ximon/Hot-tub-remote/74LVC1T45.jpg

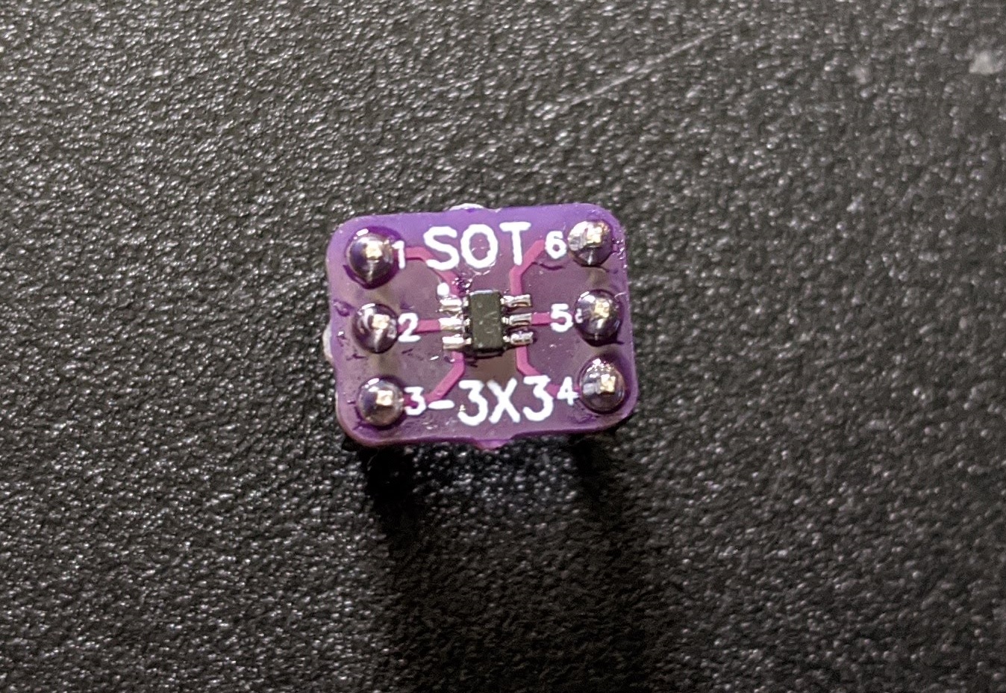
74LVC1T45.jpg
