ximon/Hot-tub-remote/OLS_Traces/interface.png

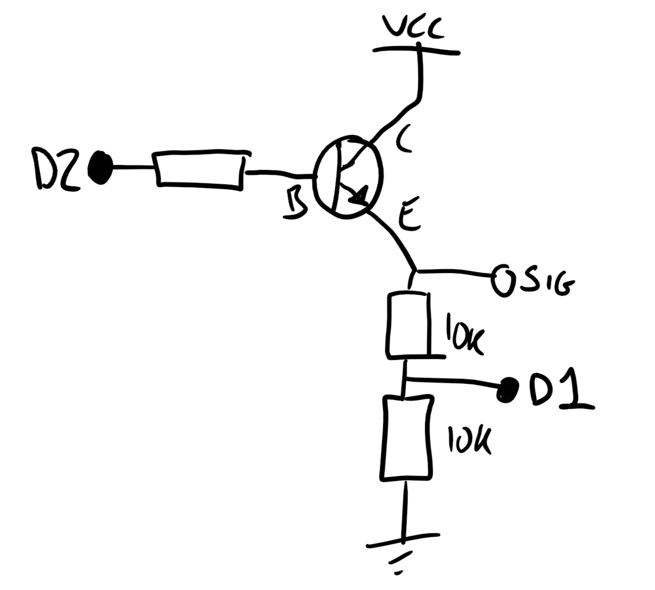
OLS_Traces/interface.png
