ximon/Hot-tub-remote/(threads)

Thread 1 (2019-08-12):

Issue with ESP8266 Arduino IDE board version 2.5.2

dominikkarall, 2019-08-12:
Hi,

can you please add
ICACHE_RAM_ATTR
before the 2 functions which are called by the interrupt handler.
```
ICACHE_RAM_ATTR void handleButtonPress() {
  sendTestCommand = true;
}

ICACHE_RAM_ATTR void handleDataInterrupt() {
  word data = receiveCommand();
  decodeCommand(data);
  lastReceivedCommand = millis();
}
```

Otherwise it crashes on startup, see also
https://github.com/esp8266/Arduino/issues/1734

Many thanks for your great work!

ximon, 2019-08-19:
I've added these, still works with 2.4.2 and now compiles and runs with 2.5.2 also, will double check tonight if moving to 2.5.2 causes any issues.

ximon, 2019-08-20:
Moving to 2.5.2 has uncovered some existing exception issues, I've rewritten the way data is read and written to completely avoid delays in the isr and use timers to check and clock the bits. Will commit after testing (tomorrow hopefully)

ximon, 2019-09-03:
I've re-wrote the data receiving code and it's working well, just looking into abusing i2s to send data with DMA.

ximon, 2019-09-03:
This issue is resolved

Closed 2019-09-03.

Thread 2 (2019-09-08):

ESPHOME compatibility

jperquin, 2019-09-08:
I am running a HASS system on RPi3b with HASSIO and ESPHOME. Mainly because ESPHOME makes managing all components so easy. I have a similar INTEX Spa (with jets and bubbles) and love to be able to use the ground work you have done (kudo's BTW) as a basis for an ESPHOME component.

My programming skills do not go beyond basic yaml, so any suggestions would be appreciated.

ximon, 2019-09-11:
I'd check that it is the three wire model first, as the other models are quite different - there's another project for the four wire model on hackaday.io which might be worht checking out.

I am looking into adding MQTT support once i've ironed out the last few niggles.

jcallaghan, 2020-03-27:
Do you have the link to the four-wire model, please?

ximon, 2020-03-27:
Sure:
[Hackaday project](https://hackaday.io/project/164551-lay-z-spa-remote-control)
[Google docs info](https://docs.google.com/presentation/d/e/2PACX-1vTHQPsuV6sXKc5gxL9crg099udq97GZqN0jf2Jnf2mCJcU21wUM8zd_1vZSeGWA5wYvWniveEIPkd5f/pub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)

ximon, 2020-04-19:
I've started working on MQTT integration on this, will update when i've made progress

jcallaghan, 2020-05-06:
This is really cool to see Simon. Great work! I have analyzed my four-wire Hawaii Hydrojet Pro and am just trying to plan my next stage to integrate using an ESP board.

ximon, 2020-05-06:
MQTT is now part of the project, accepts commands on hottub/cmnd/* and sends out status messages on any status change on hottub/state/status

Swiftnesses, 2020-06-22:
@jcallaghan I have a hydrojet pro, did you get this working on that model?

Closed 2020-05-06.

Thread 4 (2020-04-18):

6 pin version

sanyatuning, 2020-04-18:
Can anyone help me with 6 pin version: [images](https://photos.app.goo.gl/3iwWzNdyU5Ki6gqM6)
Any guess how to start?

Measured on cabels from base unit without the head:
* p1 VCC (based on photo)
* p2 GND (based on photo)
* p3 ? measured: 4.6-4-7V (pulsing, can be digital)
* p4 ? measured: 4.6-4-7V (pulsing, can be digital)
* p5 ? measured: 4.3-4.6V (pulsing, can be digital)
* p6 ? measured: 0V (no guess)

phiberjenz, 2020-04-29:
What is the model number of your pump? I have a #54112 (Swedish market, bought last year). Haven’t opened it up yet but my guess is that it is not 3-pin...

phiberjenz, 2020-04-29:
Nope, I have 4 pins :D

byles, 2020-04-29:
I have 6 pins, when it stops raining I plan to stick the logic analyser on it..

byles, 2020-04-30:
Here's a real quick capture in sigrok pulseview.
I don't really know what I'm doing :)
And it's still wet outside :(
[Archive.zip](https://github.com/ximon/Hot-tub-remote/files/4560407/Archive.zip)

sanyatuning, 2020-05-01:
@byles this is awesome, huge thanks
I have model #54314

byles, 2020-05-01:
I can't make any sense of that short capture if I'm honest... I will do it again properly as soon as the weather is better and at a higher sample rate. Any thoughts on what that connector is? I don't want to hack up mine :)

sanyatuning, 2020-05-02:
mine is [SM connector](https://www.pcboard.ca/image/cache/catalog/products/connectors/jst/jst-sm/4-pin-jst-sm-pair-1-551x551.jpg)

pdecat, 2020-05-03:
FWIW, I've got a model #54129 Palm Springs (French market bought two years ago) and it's a 4 pin.

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

byles, 2020-05-03:
The one I'll be poking around on is #54123 UK market. Thanks to sanyatuning, 6 pin connectors should be arriving in a few days!

byles, 2020-05-03:
Just a thought... I've seen they have an iphone/android app for controlling these things. I wonder if they 5/6th line is for a Wi-Fi adapter of some sort on a newer/higher model.

sanyatuning, 2020-05-05:
@byles what was the state of the hot tub when you captured this?
It was turned on?
It was filtering or heating?
What was the water temperature? (as you remember)

Thanks!

byles, 2020-05-05:
Hey sorry didn't see the email til just now.
I'm attaching a capture from earlier today.

Pin 6 is just the beep, if it's disconnected, there's no beep!

I didn't seem to get any data at all on 3,4 or 5 from the control panel when the control panel was disconnected, maybe it only sends in response to messages from pump during the gap or when polled. master/slave?

3,4 and 5 always have data sending regardless of control panel being connected.

State of machine during this capture:

On
Unlocked
No timer
Bubbles Off
Filter On
Heat On (green - standby/not heating)
35℃ (maybe 36..)

[hottub2.zip](https://github.com/ximon/Hot-tub-remote/files/4583510/hottub2.zip)

sanyatuning, 2020-05-06:
may be correct

this short message is repeating
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

sometimes there is a longer message
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

byles, 2020-05-06:
I wanted to share this before I get into it; I've taken some data with various settings.
Sorry I decoded it as LSB first, we can always change it later.

C0 01 FE 9F FE 0F FE 29 FF F7 FF    37c     heat on     filter on   bubbles off     lock off
C0 01 FE 9F FE 0F FE 21 FF F7 FF    37c     heat on     filter on   bubbles off     lock off
C0 01 FE 9F FE 0F FE 21 FF F7 FF    37c     heat on     filter on   bubbles off     lock off
C0 01 FE 9F FE 0F FE 01 FF F7 FF    37c     heat off    filter on   bubbles off     lock off
C0 01 FE 9F FE 0F FE 01 FF F5 FF    37c     heat off    filter off  bubbles off     lock off
C0 01 FE 9F FE FF FE 21 FF F7 FF    38c     heat on     filter on   bubbles off     lock off
C0 01 FE 9F FE FF FE 41 FF F7 FF    38c     heat stdby  filter on   bubbles off     lock off
C0 0D FE 7F FE 7F FE 21 FF FB FF    100f    heat on     filter on   bubbles off     lock off
C0 01 FE 9F FE FF FE A1 FF F7 FF    38c     heat on     filter on   bubbles on      lock off
C0 01 FE 9F FE FF FE 01 FF E5 FF    38c     heat off    filter off  bubbles off     lock off    -- power off
C0 01 FE 9F FE FF FE 81 FF F7 FF    38c     heat off    filter on   bubbles on      lock off
C0 01 FE 9F FE FF FE 81 FF F5 FF    38c     heat off    filter off  bubbles on      lock off
C0 01 FE 9F FE FF FE 29 FF F7 FF    38c     heat on     filter on   bubbles off     lock on
C0 01 FE 9F FE FF FE 01 FF F5 FF    38c     heat off    filter off  bubbles off     lock off

"01H" / "38" - timer on, alternating display
C0 7F FE 0D FE ED FE 35 FF F7 FF    01H
C0 01 FE 9F FE FF FE 35 FF F7 FF    38c

byles, 2020-05-06:
https://docs.google.com/spreadsheets/d/1mqK0INE1kh0g_M_HerP3LNWXHpvr-ZIPXr-yXfrYt_k/edit?usp=sharing

Sorry, I went LSB first 🙄

sanyatuning, 2020-05-07:
I am using lib [SPISlave](https://github.com/esp8266/Arduino/blob/master/libraries/SPISlave/examples/SPISlave_Test/SPISlave_Test.ino
)
and I got this:
```
[19:51:00][D][HotTub:018]: D8.C1.FE.03.FE.9F.90.FF.AF.FF.11.D8.D8.42.D8.D8.42.D8.D8.42.D8.D8.80.02.03.80.7F.B0.7F.F0.7F.80 (32)
```

byles, 2020-05-07:
So that looks the same as in my spreadsheet, more or less. You have bubbles and heat on?

All mine started C0 so I wonder what C1 is. What state was yours in?

Should I flip the data in my spreadsheet to be msb first? If you want to request edit and add to it feel free.

sanyatuning, 2020-05-07:
fully off or standby
I will capture some data in all states soon

byles, 2020-05-07:
Well, I wouldn't capture any data if it was fully off 😁

Standby, when screen is dim and not running.

sanyatuning, 2020-05-08:
How you capture the data?

byles, 2020-05-08:
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

Cheap logic analyser from Amazon and sigrok. Capturing at 250Hz just so I didn't miss anything. When it was slower sample rate, that clock line wasn't so obviously a clock.

Made jump wires with the SM connectors you identified.

sanyatuning, 2020-05-08:
Can you please share a new capture file?

byles, 2020-05-08:
The hottub2.zip above is the last one Ive done, is what makes up spreadsheet :)

sanyatuning, 2020-05-12:
@byles I wrote a code what reads the current state of the spa.
It is an esphome custom component running on a esp8266.

byles, 2020-05-12:
@sanyatuning nice, would be good to see what you've got. I was busy this weekend so wasn't able to get anything more done yet.

sanyatuning, 2020-05-12:
@byles https://github.com/sanyatuning/hot-tub

chunkysteveo, 2020-05-19:
I have a 4 pin model like @phiberjenz  - would love to get some remote monitoring and management of the 'Tub. Great work so far guys - i'm very interested in this project. Is the 4 pin going to be different to the 6 pin do you think, SPI, I2C?  - V, G, D, C?? has anyone probed the 4-pin version?

reevery, 2020-05-29:
I've also got a four pin version and have ordered some kit to start probing that. Model 54156. Not entirely sure what I'm doing, but will figure it out.

chunkysteveo, 2020-05-29:
Haha good! Keep me posted @reevery ! I suspect the lines are clock and data, and it would just be a case of reversing the protocol and copying. But I've literally no idea!! Would give me an excuse to buy a logic analyser. Was a pain walking to the bottom of the garden today to turn the heater on.... lol #firstworldproblems 😂

chunkysteveo, 2020-06-01:
Found this guys who has a diy product for sale, and uses the 4-pin model too - https://hottubmanager.co.uk/ Only has monitoring states, but surely just need to add in a sending module to the mix to add in the controls? Looks promising too!

reevery, 2020-06-08:
I have finally got round to recording data from the 4-pin.

Pins 1-4 are: vcc, signal 1, signal 2, gnd.
Starts with pump on, heat on, air off. Temp would have been early 30s centigrade. Then heat off, pump off, pump on, heat on, air on, air off, and I think air cycles again.

I really don't know what I'm looking at though.

Data is [here](https://drive.google.com/file/d/1oFCLdTXhxz-6oxqCB74gCrj8YP5WzXa-/view?usp=sharing).

chunkysteveo, 2020-06-08:
Cool! Nice work - hope someone can work with it?!

reevery, 2020-06-14:
I've been trying to make some headway but am struggling a little with direction.

From what I can work out, the 6-pin uses SPI, but I think @ximon yours is UART. Is the 74LVC1T45 then just to split your input and output out? If so, with a signal in and out line on the 4-pin I imagine I don't need this component. What was your baud rate? This is 9600 on mine - does it look similar?
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

If that is the case, then my suspicion is that I can use your code but wiring directly to the ESP.

Would the capacitor be needed in all situations and if so where is it wired in? Is it literally just across VCC and GND of the ESP?

Then the next problem is figuring out how to write the code to the Wemos. I know you posted this link (am copying here for my info mainly): https://averagemaker.com/2018/03/wemos-d1-mini-setup.html

ximon, 2020-06-14:
The hot tub i have uses a three wire cable between the display/buttons and the controller. It uses some odd protocol that i'm not familiar with - dont think it would work with UART due to the really long start pulse in comparison to the rest of the bits - It looks quite a bit different to the images above, yours won't need the 74LVC1T45 - i only needed it due to the DMA hack I'm using to send out the data.

The big capacitor is just a buffer for when the pump and blower motors turn on - It's directly across the supply.

chunkysteveo, 2020-06-24:
Hi @reevery  - I'm going to guess that the protocol is I2C for the 4 pin version. Looks like the 7 step I2C message. If it is, we may need an I2C level shifter board for the ESP to read and write back. Although if those signals are from the two data lines, then there's no clock signal - so could well be asynchronous serial communication, like UART. Hmmm?!!?

reevery, 2020-06-24:
@chunkysteveo There's definitely only two signal wires. pdecat's picture above https://github.com/ximon/Hot-tub-remote/issues/4#issuecomment-623143621 shows Vcc and Gnd on the outer wires. I'm banking on UART but I will investigate it as I2C when I get a chance.

I'm struggling to configure the Wemos at present. It appears their website is kerplunk and I haven't yet found a mirror for it. Baby steps...

eddcaton, 2020-06-25:
Looks like I have the 6 pin version as well 😭 doesn’t anyone have an update on this?

Edd

ximon, 2020-07-01:
If we can make the control code generic enough then we should be able to just #include the relevant control code for each model, I'll take a look at doing this for the current code - 3 pin model.

Can anyone share the model numbers and available dates for the other pumps

This is what i know currently:

Model No.|PinCount|Date|Comments
--|--|--|--
54075|3|~2012|Semi-circle display
54075|10|~2012|Oval display

chunkysteveo, 2020-07-01:
Model No: 54154
PinCount: 4 (Vcc, Data, Data, Gnd)
Model Name: ? From a 'Paris' Tub
Date:  2018?
Country: UK
Comments: Dark-blue/grey, Oval display. Buttons: On/Off Lock, Timer, Bubbles, °C/°F, Heat, Filter, Temp Down, Temp Up

877dev, 2020-07-03:
Hi guys, very excited to see this project, as I just got a new Vegas Lay Z Spa (6 wires). I'm in the UK.

I already have a logic analyser, and have used it to interface with my Accenta alarm panel to create a "virtual" keypad on my phone. (I need to update my github to include that).

Looks like I need some 6pin SM connectors so I can get sniffing!

der-moep, 2020-07-12:
Model No. | PinCount | Protocol | Model Name | Date | Country | Colour | Comments
54123 | 4 | -- | Miami | 2018 | Germany | Grey | Round display
54174 | 6 | -- | Honolulu | 2020 | Germany | Grey | Round display

ximon, 2020-07-14:
> Model No. | PinCount | Protocol | Model Name | Date | Country | Colour | Comments
> 54123 | 4 | -- | Miami | 2018 | Germany | Grey | Round display
> 54174 | 6 | -- | Honolulu | 2020 | Germany | Grey | Round display

Thanks! I've added these to the main list.

877dev, 2020-07-15:
Model No. | PinCount | Protocol | Model Name | Date | Country | Colour | Comments
54112        |    6           |   SPI ?     |     Vegas        | 2020 |     UK     |    Grey  | Round display

ximon, 2020-07-15:
> Model No. | PinCount | Protocol | Model Name | Date | Country | Colour | Comments
> 54112 | 6 | SPI ? | Vegas | 2020 | UK | Grey | Round display

Thanks! I've added this to the main list.

Friseurazubi, 2020-08-03:
Here is the next model ;)

Model | PinCount | Protocol | Name | Date | Country | Colour | Comm
54173 | 4 | ? | Maldives HydrojetPro | 2020 | Germany | Grey | 2 WaterPump

Hawaii HydrojetPro should have the same controller.

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

danjunx, 2020-08-09:
Love this idea! Really interesting in helping out if I can.
I've got 2 Vegas model spas here, one is older than the other by a couple of years, however the internals of the pump "egg" are identical bar some different PCB rev numbers, they have the same model numbers.

I've been doing a bit of googling around and found this project among a few others specifically for the 4 pin version - according to this document, it's using UART, and I can confirm that. [link](https://docs.google.com/presentation/d/e/2PACX-1vTHQPsuV6sXKc5gxL9crg099udq97GZqN0jf2Jnf2mCJcU21wUM8zd_1vZSeGWA5wYvWniveEIPkd5f/pub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)

Following the bit pattern settings on the above document, I was able to hook into the TX/RX sides and sniff the traffic from the control panel/display to the controller unit and see the data being sent between them both. Was not able to sniff the data going the other direction for whatever reason.
I can provide some direct dumps of the serial output from the control panel/display while going through the various functions if required.

Regarding the model number of the pump "eggs" I have and their details:

Model No. | PinCount | Protocol | Model Name | Date | Country | Colour | Comments
54112 | 4 | UART | Vegas | 2015 | UK | Grey | round display, lock/timer/pump/C-F/heater/bubbles/temp up/down, one has a "test" button in place of the power button.

Am curious about the 2 PROG headers on the boards, may be worth trying to dabble with them although I definitely don't have kit to do so at the moment - it looks like there's replacement controller boards for relatively cheap on ebay (at least here in the UK!) and I was tempted to pick one up to dabble with instead of working with my spare pump.

Couple of photos below, note the pinout of the white 4 pin display connector down the bottom left of the board, also the PROG2 header.

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

chunkysteveo, 2020-08-09:
That link is fascinating reading. Need to look into the links to their software etc. Not sure why they have an extra blower button though? Good find though!

faboaic, 2020-08-15:
You all know this one ?
That's what I will try with my lay-z-spa Miami.

https://github.com/visualapproach/WiFi-remote-for-Bestway-Lay-Z-SPA

chunkysteveo, 2020-08-16:
That's a great find too!

ricoghardforth, 2020-10-08:
Is anyone getting anywhere with a four wire version for a esp2866 solution.  Thanks

pejov74, 2020-10-09:
> Is anyone getting anywhere with a four wire version for a esp2866 solution. Thanks

Im also looking for a four wire version for a esp2866 solution.

markgdev, 2020-10-16:
I've been having a look at this based on the link above, I'm hoping to have a basic setup to test in the next few days. Assuming the comms between the display and controller match for my model 🤞

ximon, 2020-10-21:
Not much progress on this lately as my tub's pump shaft has snapped and its dismantled for the time being :(

I'm quite happy to chip in and help with anything though.

TimE90, 2020-12-20:
Did anyone figure out the 4 pin models? Mine is a Lay Z Palm Springs and has four wires. Seems like V, GND and two data’s.
![Uploading D11F6C71-D560-4638-927C-AB089E7056A3.png…]()

markgdev, 2021-01-01:
@TimE90, I’ve finally got a prototype running today. I’ve had to loose the ability to control through the top panel as there is no way to feedback to it that I can find other than the temp. I have kept the blower button active though and this overrides whatever is set remotely.
I will clean up my code and get some details together in the next couple of days and post on here.

TimE90, 2021-01-01:
@markgdev congratulations this sounds pretty good! I‘m looking forward to your updates 👍

markgdev, 2021-01-04:
As promised, I've put some details together here: `https://github.com/markgdev/layzspa_remote` It's still very much a work in progress but the hot tub as been running for the last couple of days now so looks promising.

sanyatuning, 2021-01-04:
@markgdev this looks promising! Thanks for the share!

obalthaz, 2021-01-07:
> As promised, I've put some details together here: https://github.com/markgdev/layzspa_remote It's still very much a work in progress but the hot tub as been running for the last couple of days now so looks promising.

hello, I tested yesterday on my spa, everything works as described.  thank you so much

jenswalit, 2021-04-18:
Hello. I have an 4Pin Lay Z Spa Vegas. I will use your project. Can you say the pin out are the same as yours? Pump No 54112. thank you

sanyatuning, 2021-05-25:
Finally this worked for me: https://github.com/visualapproach/WiFi-remote-for-Bestway-Lay-Z-SPA
but be careful some pins always pulled up/down and cant be used with level shifters

Closed 2021-05-25.

Thread 6 (2020-05-06):

Question : More Informations on electronic part

RonandoDeLaVega, 2020-05-06:
Hello,

First of all, well done for your work, this looks amazing !!

I'm a bit new in eletronic and I can't figure out how you made your schema ? Do you have photos of actual PCB ?

Where the condensator should be linked to ?
What is the component in the middle with VCCA VCCB A B and DIR in entries ?

Thanks !
Ronando

eddcaton, 2020-05-08:
Yes @RonandoDeLaVega  would be good to have a more in depth electrical connection guide.

ximon, 2020-05-10:
Hi,

The esp8266 talks to the hot tub via the three pin cable between the display and the main controller.
This is done through a level shifter, a 74LVC1T45, this is the component with the VCCA,VCCB, A, B and DIR pins.

The level shifter is used as the hot tub signals are 5v and the esp8266 is 3v3, its also used to turn the output on and off before and after sending commands as its using a DMA hack which doesnt quite produce the required signals.

The condensator (capacitor) is connected across the supply just to smooth out the dips when the esp8266 is transmitting.

I've updated the schematic to clear up the net names and swap the diode with a switch to aid in local programming.

I cant upload a photo of the device as it's inside my hot tub, next time i have it open i'll take a photo.

Hope this helps!
Simon.

jampez77, 2020-05-19:
So I've just bought some 74LVC1T45's and I was wondering 1, how on earth you connected them the anything and 2, do you know where I can get a non-mircoscopic version of them?

Simon-Keen, 2020-05-19:
I soldered one onto [this breakout board](https://oshpark.com/shared_projects/8Vwts4jC)

You can use any non-inverting bidirectional three state driver with direction input.

ximon, 2020-05-19:
I soldered one onto [this breakout board](https://oshpark.com/shared_projects/8Vwts4jC)

You can use any non-inverting bidirectional three state driver with direction input.

RonandoDeLaVega, 2020-05-19:
Hello,
I found [this ](https://fr.aliexpress.com/item/32866573215.html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,searchweb201602_,searchweb201603_)which looks to be useful

jampez77, 2020-05-19:
> Hello,
> I found [this ](https://fr.aliexpress.com/item/32866573215.html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,searchweb201602_,searchweb201603_)which looks to be useful

From what I've seen, both online and in person, the 74LVC1T45's are tiny. Smaller than the sockets in that url.

Simon-Keen, 2020-05-19:
This is the [74LVC1T45GW SOT-363](https://uk.rs-online.com/web/p/buffer-converter-combinations/8168791/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) mounted to [this breakout](https://oshpark.com/shared_projects/8Vwts4jC)

If anybody needs one i now have two spare breakoutboards with 74LVC1T45s mounted.

It's pretty easy to solder, just tin one pad, place the part, reflow the pad, then solder the others.
Thin solder, flux and a good iron make it really easy.

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

ximon, 2020-05-19:
This is the [74LVC1T45GW SOT-363](https://uk.rs-online.com/web/p/buffer-converter-combinations/8168791/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) mounted to [this breakout](https://oshpark.com/shared_projects/8Vwts4jC)

If anybody needs one i now have two spare breakoutboards with 74LVC1T45s mounted.

It's pretty easy to solder, just tin one pad, place the part, reflow the pad, then solder the others.
Thin solder, flux and a good iron make it really easy.

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

RonandoDeLaVega, 2020-05-19:
Hello,

Here is my shop list, does it seems right to you ?
I've got a doubt on the capacitor : is 16V OK ?

- [switch](https://www.aliexpress.com/item/32832214619.html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,searchweb201602_,searchweb201603_)
- [capacitor](https://www.aliexpress.com/item/32954075821.html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,searchweb201602_,searchweb201603_)
- [Wemos D1 Mini](https://www.aliexpress.com/item/32651747570.html?spm=a2g0s.9042311.0.0.54e04c4dNBfryS)
- [74LVC1T45 ](https://www.aliexpress.com/item/33020199381.html?spm=a2g0s.9042311.0.0.54e04c4dNBfryS)
- [SOT23 adaptator](https://www.aliexpress.com/item/33020199381.html?spm=a2g0s.9042311.0.0.54e04c4dNBfryS)

After I'll receive all this stuff, I'll have to figure out how to flash the ESP8266 ... any keyword to search on google ? :-D

Thanks a lot !
Ronando

jampez77, 2020-05-19:
>
> After I'll receive all this stuff, I'll have to figure out how to flash the ESP8266 ... any keyword to search on google ? :-D
>

Try this:  https://averagemaker.com/2018/03/wemos-d1-mini-setup.html

ximon, 2020-05-21:
@RonandoDeLaVega  Your list seems fine apart from the sot adapter, the link is for the 74lvc1t45.
The switch is optional, you can just use a jumper if you have one spare.

You might want to check out the platformio branch too, i'm moving away from the arduino ide so all new updates will be in that branch and will eventually be merged into master.

eddcaton, 2020-06-19:
Hey,

Can anyone tell me if this is the right part?
https://www.ebay.co.uk/itm/193386434279

Edd

ximon, 2020-06-19:
Hi Edd, yeah, that'll do the job

eddcaton, 2020-06-19:
Thanks :)

dominikkarall, 2020-06-21:
Hi,
I got my 74LVC1T45 today, but unfortunately I haven't found a capacitor in my spare components. Do I really need it and is it necessary to be exactly the 1000uF one you have in your semantics? I just wired it together without capacitor. Receiving signals works perfect, but sending doesn't work at all (branch: platformio-fixes).

ximon, 2020-06-21:
The size of the capacitor isn't super critical, its just a local buffer for when the pumps turn on, you might get away without it - I added it at the time when I was seeing a lot of exceptions occurring, seemed to make a difference - but it could also have been code changes.

It might be worth hooking a scope up to the supply to the esp and watching what happens when the heater / pump turns on / off.

With regards to the platformio-fixes branch - I mistakenly checked some work in that wasn't fully tested and had to spend some time unpicking the parts that worked. I've rewrote the receiveing code which seems a lot more accurate in decoding the messages ( I tried this method before but kept seeing exceptions )

I'll check in the latest changes once i've got it tested.

dominikkarall, 2020-06-24:
I just tested it with a 1000uF capacitor, unfortunately it still doesn't work. Can you please let me know if you use the 5V from the 3-wires to run the ESP8266? Receiving works perfectly, but sending doesn't work at all. It seems to send some signals as I can see all lights flashing very short on the hot tub display.

ximon, 2020-06-24:
Yes - mine is soleley powered from the tub using the three wires going to the display controller.

Try with the main branch, i've merged the new platormio code in which runs a lot better for me.

Do you have a logic analyser you can check things out with if it still doesn't work?

Thread 7 (2020-05-11):

Changing temperature from the esp doesn't result in the correct temperature

ximon, 2020-05-11:
When changing the temperature from the esp it seems to under / overshoot the temperature it's aiming for

ximon, 2020-05-11:
It's just occurred to me that this will be caused by the temperature reading for the target temperature only being taken once and won't be read again until the display stops flashing, then starts flashing again.

The target temperature readings need to be taken until the display stops flashing or temp up / down commands are no longer being sent.

ximon, 2020-05-26:
Resolved in platformio branch

Closed 2020-05-26.

Thread 8 (2020-06-01):

Error state detection broken

ximon, 2020-06-01:
Detection of error states seems to be broken, pump was showing E02 but the status JSON wasn't showing the error.

ximon, 2020-06-23:
Fixed in platformio-fixes branch

Closed 2020-06-23.

Thread 9 (2020-06-04):

Installation Instructions

jampez77, 2020-06-04:
I'm really keen to try this idea on my hot tub. Would it be possible to have some info on how you installed it on yours?

Even if it's just some photos of your setup.

Thanks

Simon-Keen, 2020-06-05:
I didn't take pictures when i was connecting it up but its just a case of tapping into the three wires that connect the main controller to the display.

There will be vcc, data and ground wires - I used a multimeter to determine which was which.

Just connect the vccr, data and ground to the relevant pins on the schematic (labelled hot tub)
(think i missed it from the schematic but the vcc will also need to go to the d1 mini's 5v in)

Thread 10 (2020-06-22):

HTML Interface

eddcaton, 2020-06-22:
Hey All,

I have this system working now and it's great!

Just one question. In the download, there is a folder TestPage with an HTML index file in it. Has anyone been able to get this installed and working? If so how? As I don't really need to use the REST API with the way I have set things up. I would just like a webpage I can logon to.

Edd

ximon, 2020-06-23:
I have a really basic page that I use for testing, its has no styling and is completely unfinished - I am planning on making it a bit nicer but I've been concentrating on making the receiving code rock solid.

Feel free to create one that talks to the API and submit a PR 👍

eddcaton, 2020-06-23:
Hey @ximon,

Would you mind posting the version you have and I will take a look at styling etc.

Edd

ximon, 2020-06-24:
You should be able to run the test page from a webserver / githack.

[Try this](http://raw.githack.com/ximon/Hot-tub-remote/87d7ac6020e7dc4f0b9f96ada929dea6b3f97524/TestPage/index.html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) - Just swap the ip in the querystring with whatever your esp local ip is

chunkysteveo, 2020-07-01:
I'd be happy to style up the interface page with a nice and simple Bootstrap layout. If the 4-pin version is ever cracked!! lol

ximon, 2020-07-01:
I started writing an interface in angular using material design, check out the HotTubRemoteUI branch

chunkysteveo, 2020-07-01:
Ah coo, i'll leave you to it then. 👍

ximon, 2020-07-01:
I'm not a designer mind, so if you fancy putting something together with angular material go for it 👍

chunkysteveo, 2020-07-01:
Never used Angular material to build, i'm a PHP dev and work with classic HTML, CSS, JS. I'd have to start from scratch 😒 😄

eddcaton, 2020-07-01:
I have started a php layout using curl requests which is shaping up quite nicely. Just need to workout how to get the pump and bubble status so I can display its value on the dashboard. Also I can’t currently test fully as I have the 6 pin version  :(

Thread 14 (2020-06-30):

Stability Issues

ximon, 2020-06-30:
Everything seems to be really unstable with multiple restarts happening often, also pin change interrupts seem to miss some transitions and mess with the message receiving.
This seems to have increased since moving to timer and interrupt driven message decoding.

Current options for this, in order of preference:

1. Look into removing the timers and doing message encoding / decoding in loop()
2. Have a separate IC do the message encoding / decoding and talk to the esp8266 over serial
3. Use an esp32 and dedicate one core or the ULP to the message encoding / decoding.

Anyone have any thoughts / suggestions / tips?

dmeagor, 2020-07-01:
I'm certainly no expert but I would think that option 3 is the cleanest solution as one $5 dev board can then handle everything.  Option 1 and 2 looks like unnecesseswary development with Option 1 looking like a a bodge.  Seems like the 8266 is being phased out anyway.  Tiny bonus, you could potentially use the esp32 internal temperature sensor to monitor outside temp (after calibrating with an offset.)

ximon, 2020-07-01:
Esp32 was my last choice purely because I was determined to get this running perfectly on the esp8266 but it's been plagued with problems since I started the project - I think it's down to the frequency of the interrupts.

I have a couple of esp32 dev boards spare I'll do some testing with and see how things go. Hopefully it'll be as simple as having WiFi one one core and everything else on the other, I haven't looked deeply into the ulp but it from what I have heard it sounds like an ideas choice for decoding.

ximon, 2020-07-01:
Pretty sure the IRRemote library does its receiving/decoding from a function called in loop, works perfectly at the low message rates I have used it for - could be a simple solution with not a lot of effort.

chunkysteveo, 2020-07-02:
ESP8266 seem to struggle with high demand things theses days. I remember when the ESP32 was a luxury board to use - seems like it's becoming the go-to board now unless you have something simple with limited pins etc.

ximon, 2020-07-02:
I'll branch the current esp8266 code and make another branch for the esp32, once confirmed it's working i'll merge the esp32 code into main and leave the esp8266 for reference.

Thread 15 (2020-11-21):

Water pump rattles

visualapproach, 2020-11-21:
Not much progress on this lately as my tub's pump shaft has snapped and its dismantled for the time being :(

I'm quite happy to chip in and help with anything though.

_Originally posted by @ximon in https://github.com/ximon/Hot-tub-remote/issues/4#issuecomment-713896636_
