ximon/Hot-tub-remote/Interface/Interface.sch

## KiCad design Interface/Interface.sch (2020-06-24, an earlier design)

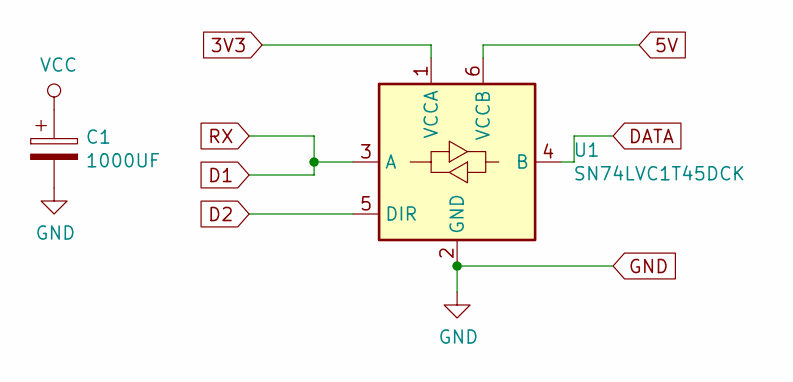
[picture p7: schematic Interface.sch]

Parts:
C1: 1000UF
U1: SN74LVC1T45DCK; SOT-363_SC-70-6

Connections:
3V3: U1.1 (VCCA)
5V: U1.6 (VCCB)
D1: U1.3 (A)
D2: U1.5 (DIR)
DATA: U1.4 (B)
GND: C1.2, U1.2 (GND)
VCC: C1.1
