ximon/Hot-tub-remote/src/HotTub.h

#ifndef HOTTUB_H
#define HOTTUB_H

#include <ArduinoJson.h>
#include "Commands.h"
#include "Temperatures.h"
#include "SendReceive.h"
#include "State.h"

#include <Syslog.h>

#define INIT_TEMP 37 //Temperature to initially set to when powering up.

#define WAIT_BETWEEN_SENDING_AUTO_COMMANDS 500
#define WAIT_BEFORE_INITIAL_TARGET_TEMP_CHECK 5000 //milliseconds after startup to wait before checking the initial target temperature

#define DELAY_BETWEEN_PRINTS 1000

#define TEMP_BUTTON_DELAY 2000         //time to wait after a button is pressed to run the target temperature check
#define TEMP_TARGET_INITIAL_DELAY 6000 //Time to wait before sending a button command to get the target temperature
#define TEMP_CURRENT_DELAY 6000        //Time to wait before taking the reading as the current temperature
#define TEMP_TARGET_DELAY 250          //Time to wait before taking the reading as the target temperature

#define TEMP_ADJUST_DELAY 3000 //must be less than TEMP_IGNORE_TIME!!
#define BUTTON_SEND_DELAY 1000 //time to wait before sending buttons to change state

class HotTub : public SendReceive
{
public:
  HotTub(int dataInPin, int dataOutPin, int debugPin, Syslog *syslog);

  CurrentState *getCurrentState();
  TargetState *getTargetState();
  void setTargetState(int newState);
  int setTargetTemperature(int temp); //todo - setting in EEPROM

  int setLimitTemperature(int temp); //todo - setting in EEPROM
  int getLimitTemperature();

  int targetTemperatureValid(int targetTemp); //todo - make private and do all temperature validation in this class
  int maxTemperatureValid(int maxTemp);       //todo - make private and do all temperature validation in this class
  int tempValid(int temperature, int minTemp, int maxTemp);

  void setTemperatureLock(bool enable); //todo - setting in EEPROM
  void setAutoRestart(bool enable);     //todo - setting in EEPROM

  char *getStateJson();

  void onCommandSent(unsigned int command);
  void onCommandReceived(unsigned int command);

  void loop();
  void setup(void (&onStateChange)(const char *reason), void (&onSetTimer)(uint32_t ticks));

private:
  void (*stateChanged)(const char *reason);

  Syslog *logger;

  CurrentState *currentState;
  TargetState *targetState;

  unsigned long tempIgnoreStart = 0; //start time to ignore temperature commands from

  bool manuallyTurnedOff;          //indicates to the autoRestart code that the pump was turned off via the button / command, rather than the 24h timeout
  int limitTemperature = MAX_TEMP; //limits the temperature that can be set to via the control panel
  bool limitTemperatureIsCelsius;

  bool temperatureLockEnabled = false; //todo - setting in EEPROM
  bool autoRestartEnabled = true;      //todo - setting in EEPROM

  void autoRestartCheck();
  void targetTemperatureCheck();
  void adjustTemperatures();
  void targetStateCheck();

  int decodeStatus(unsigned int statusCommand);
  int decodeError(unsigned int errorCommand);
  int decodeTemperature(unsigned int temperatureCommand);

  void handleReceivedError(unsigned int command);
  void handleReceivedStatus(unsigned int command);
  void handleReceivedTemperature(unsigned int command);
  void handleReceivedButton(unsigned int command);
  void handleTempButtonPress(unsigned int command);

  void tempButtonPressed();
  void updateTargetTemperature(int temperature);
  void updateCurrentTemperature(int temperature);

  const char *stateToString(int pumpState);
  const char *errorToString(int errorCode);
  const char *buttonToString(int buttonCommand);
  const char *tubModeToString(int tubMode);

  void setReceivedTemperature(int temperature);

  unsigned long lastButtonPressTime;

  int tubMode = TM_NORMAL;
};

#endif
