ximon/Hot-tub-remote/src/HotTub-Status.cpp

#include "HotTub.h"

void HotTub::handleReceivedStatus(unsigned int command)
{
    int decodedState = decodeStatus(command);

#ifdef DEBUG_TUB_VERBOSE
    logger->logf("HOTTUB->Decoding status command, state is %s", stateToString(currentState->pumpState));
#endif

    if (decodedState == PUMP_UNKNOWN)
        return;

    //if we dont yet have a target state, just pick up the current state as the target.
    if (targetState->pumpState == PUMP_UNKNOWN)
    {
        if (decodedState == PUMP_HEATER_STANDBY)
            decodedState = PUMP_HEATING;

        targetState->pumpState = decodedState;
        stateChanged("Setting initial state");
        return;
    }

    //we receive a CMD_END when the pump has been running 24Hrs
    //todo - might need a delay to prevent ERROR 1
    if (command == CMD_END)
    {
        if (autoRestartEnabled)
        {
            logger->log("HOTTUB->Received CMD_END, ignoring (AutoRestart enabled)");
        }
        else
        {
            logger->log("HOTTUB->Received CMD_END, turning pump off (AutoRestart disabled)");
            currentState = PUMP_OFF;
            stateChanged("Pump Turned off - 24hr timeout");
        }

        return;
    }

    if (currentState->pumpState != decodedState)
    {
        char msg[60];
        sprintf(msg, "State changed from %s to %s", stateToString(currentState->pumpState), stateToString(decodedState));

        currentState->pumpState = decodedState;
        currentState->errorCode = 0;

        stateChanged(msg);
    }
}

void HotTub::handleReceivedError(unsigned int command)
{
    int errorCode = decodeError(command);

    if (errorCode == 0)
        return;

    if (currentState->pumpState == PUMP_ERROR && currentState->errorCode == errorCode)
        return;

    currentState->pumpState = PUMP_ERROR;
    currentState->errorCode = errorCode;
    stateChanged("Error received");

#ifdef DEBUG_TUB
    logget->logf("HOTTUB->Error code %i - %s", currentState->errorCode, errorToString(currentState->errorCode));
#endif
}

CurrentState *HotTub::getCurrentState()
{
    CurrentState *state = new CurrentState();

    state->autoRestartCount = currentState->autoRestartCount;
    state->errorCode = currentState->errorCode;
    state->pumpState = currentState->pumpState;
    state->targetTemperature = currentState->targetTemperature;
    state->temperature = currentState->temperature;
    state->temperatureIsCelsius = currentState->temperatureIsCelsius;

    return state;
}

TargetState *HotTub::getTargetState()
{
    TargetState *state = new TargetState();

    state->pumpState = targetState->pumpState;
    state->targetTemperature = targetState->targetTemperature;

    return state;
}

void HotTub::setTargetState(int newState)
{
    if (targetState->pumpState != newState)
    {
#ifdef DEBUG_TUB
        logger->logf("HOTTUB->Changing state from %s to %s", stateToString(targetState->pumpState), stateToString(newState));
#endif

        targetState->pumpState = newState;
        stateChanged("Target state changed");
    }
}

void HotTub::setAutoRestart(bool enable)
{
    autoRestartEnabled = enable;
    stateChanged("Auto-Restart changed");
}

char *HotTub::getStateJson()
{
    const size_t capacity = 2 * JSON_OBJECT_SIZE(7) + JSON_OBJECT_SIZE(6);
    DynamicJsonDocument doc(capacity);
    char *json = new char[300];

    CurrentState *currentState = getCurrentState();
    JsonObject currentJson = doc.createNestedObject("currentState");
    currentJson["pumpState"] = currentState->pumpState;
    currentJson["temperature"] = currentState->temperature;
    currentJson["targetTemperature"] = currentState->targetTemperature;

    TargetState *targetState = getTargetState();
    JsonObject targetJson = doc.createNestedObject("targetState");
    targetJson["pumpState"] = targetState->pumpState;
    targetJson["targetTemperature"] = targetState->targetTemperature;

    doc["autoRestart"] = autoRestartEnabled;
    doc["limitTemperature"] = getLimitTemperature();
    doc["temperatureLock"] = temperatureLockEnabled;
    doc["errorCode"] = currentState->errorCode;
    doc["tubMode"] = tubMode;

    serializeJson(doc, json, 300);
    return json;
}
