ximon/Hot-tub-remote/src/Temperatures.h

#ifndef TEMPERATURES_H
#define TEMPERATURES_H

#define MAX_TEMP 40 //Maximum temperature supported by the hot tub
#define MIN_TEMP 20 //Minimum temperature supported by the hot tub

#define TEMP_40C 0xB5F
#define TEMP_39C 0xB63
#define TEMP_38C 0xB66
#define TEMP_37C 0xB69
#define TEMP_36C 0xB6C
#define TEMP_35C 0xB72
#define TEMP_34C 0xB77
#define TEMP_33C 0xB78
#define TEMP_32C 0xB7D
#define TEMP_31C 0xB82
#define TEMP_30C 0xB87
#define TEMP_29C 0xB88
#define TEMP_28C 0xB8D
#define TEMP_27C 0xB93
#define TEMP_26C 0xB96
#define TEMP_25C 0xB99
#define TEMP_24C 0xB9C
#define TEMP_23C 0xBA0
#define TEMP_22C 0xBA5
#define TEMP_21C 0xBAA
#define TEMP_20C 0xBAF
#define TEMP_19C 0xBB1
#define TEMP_18C 0xBB4
#define TEMP_17C 0xBBB
#define TEMP_16C 0xBBE
#define TEMP_15C 0xBC3
#define TEMP_14C 0xBC6
#define TEMP_13C 0xBC9
#define TEMP_12C 0xBCC
#define TEMP_11C 0xBD2
#define TEMP_10C 0xBD7
#define TEMP_9C  0xBD8

#define TEMP_104F 0xA5E
#define TEMP_102F 0xA67
#define TEMP_101F 0xA68
#define TEMP_99F  0xA73
#define TEMP_97F  0xA79
#define TEMP_95F  0xA83
#define TEMP_93F  0xA89
#define TEMP_92F  0xA8C
#define TEMP_90F  0xA97
#define TEMP_88F  0xA9D
#define TEMP_86F  0xAA4
#define TEMP_84F  0xAAE
#define TEMP_83F  0xAB0
#define TEMP_81F  0xABA
#define TEMP_79F  0xAC2
#define TEMP_77F  0xAC8
#define TEMP_75F  0xAD3
#define TEMP_74F  0xAD6
#define TEMP_72F  0xADC
#define TEMP_70F  0xAE5
#define TEMP_66F  0xAF4
#define TEMP_65F  0xAFB
#define TEMP_63F  0xB00
#define TEMP_61F  0xB0A
#define TEMP_59F  0xB11
#define TEMP_57F  0xB1B
#define TEMP_56F  0xB1E
#define TEMP_54F  0xB27
#define TEMP_52F  0xB2D

#endif
