ximon/Hot-tub-remote/(commit log)

2019-08-05 Update Hot-tub-remote.ino
    Reorganised some code, added interrupt handler for serial stream
2019-08-05 Added some logic traces
    Added some logic traces
2019-08-06 Added driver diagram
    Added diagram for interface driver (in yenka)
2019-08-07 Update signals.xml
    Added all missing signals (temperatures and statuses) and updates descriptions to be less cryptic
2019-08-09 Update Interface.yka
    Added actual pin numbers, button and capacitor to schematic.
2019-08-09 Update Interface.png
    Added actual pin labels, new button and capacitor
2019-08-11 Signals and schematics changes
    Added some more signal info, updated schematic with improved values
2019-08-15 Added remaining temperatures
    Added remaining temperatures
2019-08-17 Button command corrections
    Corrected commands for the buttons
    [Commands.h]
2019-08-18 Multiple improvements
    Improved sending commands by queueing them first and sending them after commands are received.
    Reduced waiting time whilst receiving commands by toggling between rising and falling interrupts around the time the start pulse is received.
2019-08-18 Update index.html
    Added more test buttons to the test page
2019-08-18 Capture target temp on external change
    Get target temperature from controller when the temperature is changed by the temp up / down commands (not buttons)
2019-08-19 Update Hot-tub-remote.ino
    Added ICACHE_RAM_ATTR to interrupt handlers
2019-08-19 Update HotTub.cpp
    Handle commands with data interrupt enabled
2019-08-21 Signal Simulator improvements
    Signal simulator is now using interrupt driven code to send / receive commands, seems to work perfectly
2020-03-04 Rework
    Lots of refactoring to try improve reliability of sending and receiving commands and fix the exceptions
    [HotTub.cpp, HotTub.h]
2020-04-19 Target temp fix
    Fixed bug where target temperature was not getting received properly, resulting in continuous sending of Temperature down commands attemping to get target temperature
    [Interface.kicad_pcb, Interface.sch]
2020-04-19 Updated interface schematic
    Updated interface schematic, now using 1 bit bus transceiver
    [Interface.sch]
2020-05-02 Added MQTT + tweaks
    Added MQTT and parameters to config page, reworked API, tweaked interface schematic, improved test page.
    [Interface.sch]
2020-05-10 reworked lots, started splitting larger files up, fixed mqtt (included modified PubSubClient)
    [Commands.h, HotTub-Buttons.cpp, HotTub-Decoders.cpp, HotTub-Status.cpp, HotTub-Temperature.cpp, HotTub.cpp, HotTub.h]
2020-05-10 Updated schematic
    [Interface.sch]
2020-05-26 Reworked temperature detection and adjustment
    [HotTub-Buttons.cpp, HotTub-Status.cpp, HotTub-Temperature.cpp, HotTub.cpp, HotTub.h, SendReceive.cpp, SendReceive.h]
2020-06-10 swap digitalRead to GPIP, resolve crash attempt?
    (cherry picked from commit e8b7d75f0205c8789e14b17ad3cc4c7d587bc366)
    [SendReceive.cpp]
2020-06-10 Reworked button handling
    (cherry picked from commit ba26c0ce7d39384f2593ffaef29b34caf1ad4357)
    [HotTub-Buttons.cpp]
2020-06-10 Attempt at improving temp button handling
    (cherry picked from commit 27b71e389a79a18d5f2bc43e44f2b54cc1226599)
2020-06-10 Added missing prototypes
2020-06-11 Error state detection fix
    [Commands.h, HotTub.cpp]
2020-06-11 temperature logging tweaks
2020-06-12 Log when not changing temperature when it should
2020-06-12 Reset tub mode if stuck in flashing state
    [HotTub-Temperature.cpp]
2020-06-13 Extracted pump states and tub modes
2020-06-13 Change error code if error canges
    [HotTub-Status.cpp]
2020-06-14 Swap String with char,logging tweaks, new clientId
    [HotTubMqtt.cpp]
2020-06-15 Figured out unknown commands, decoder needs fixing
    [Commands.h]
2020-06-21 log mqtt raw command errors
    [HotTubMqtt.cpp]
2020-06-24 Added images of prototype
2020-06-24 Updated schematic with missing vcc connections
    [Interface.sch]
2020-07-15 Added 6 wire model 54112
2020-07-24 Added info for 10 pin model
